abdelhadi16/esp32-drone-fc/hardware/pcb_3d_view.png

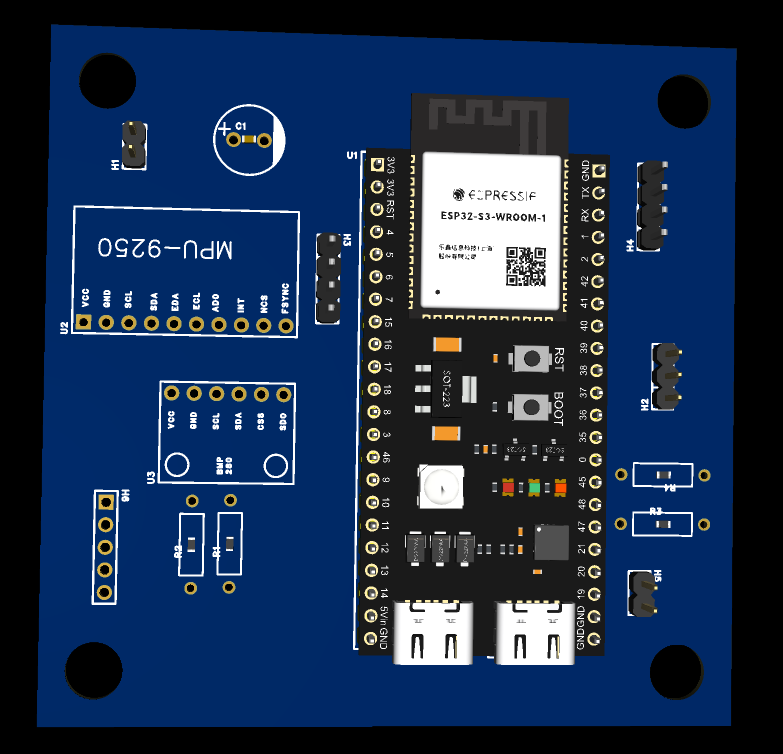
hardware/pcb_3d_view.png
